PolGs/TaulaMobil_Android/Final code 1.PNG

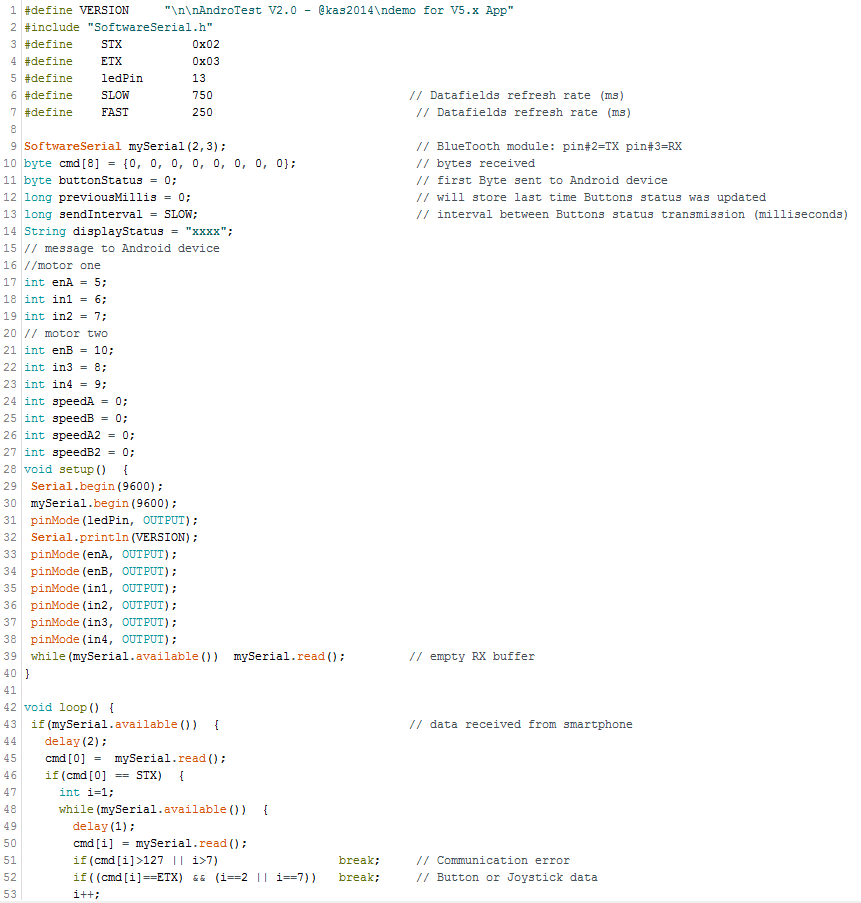
Final code 1.PNG
