PolGs/TaulaMobil_Android/Final code 2.PNG

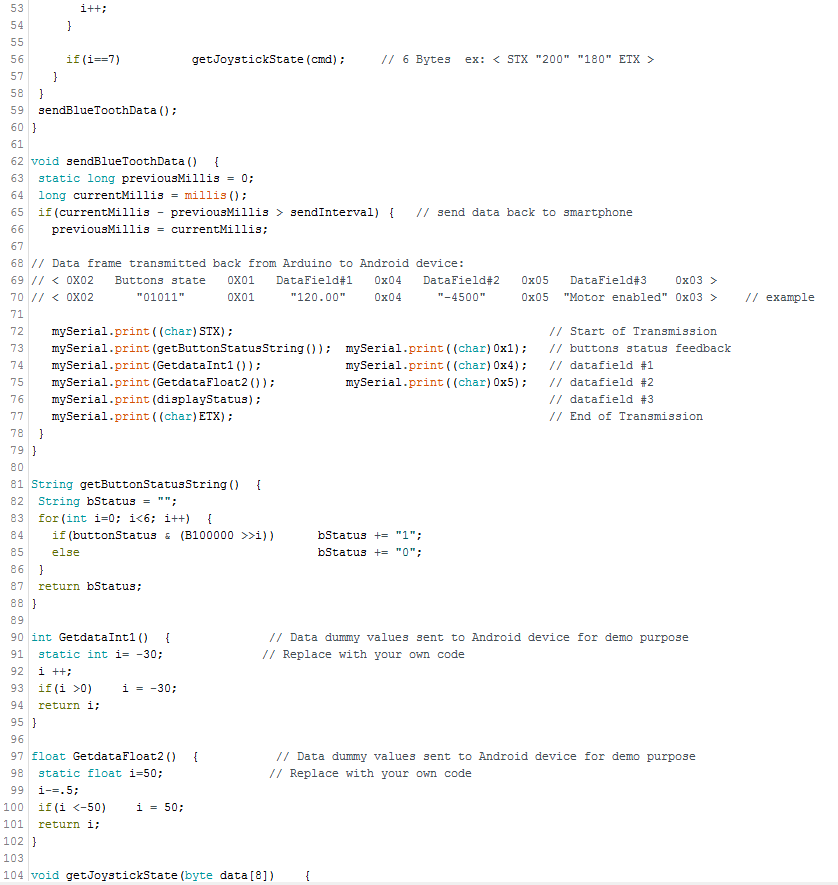
Final code 2.PNG
