PolGs/TaulaMobil_Android/Final code 3.PNG

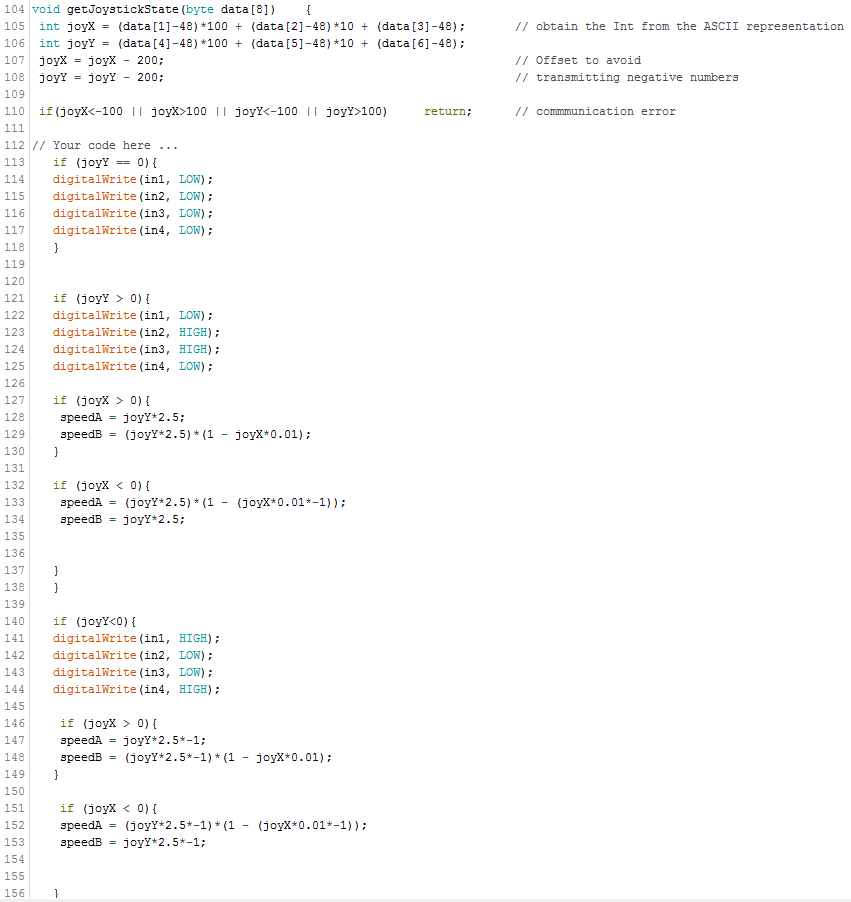
Final code 3.PNG
