PolGs/TaulaMobil_Android/Final code 4.PNG

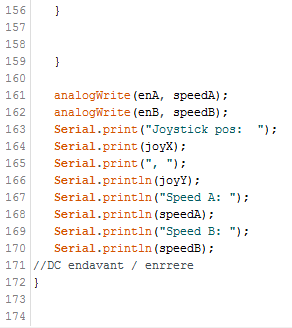
Final code 4.PNG
